zainahm3d/roadster-charger/readme.md

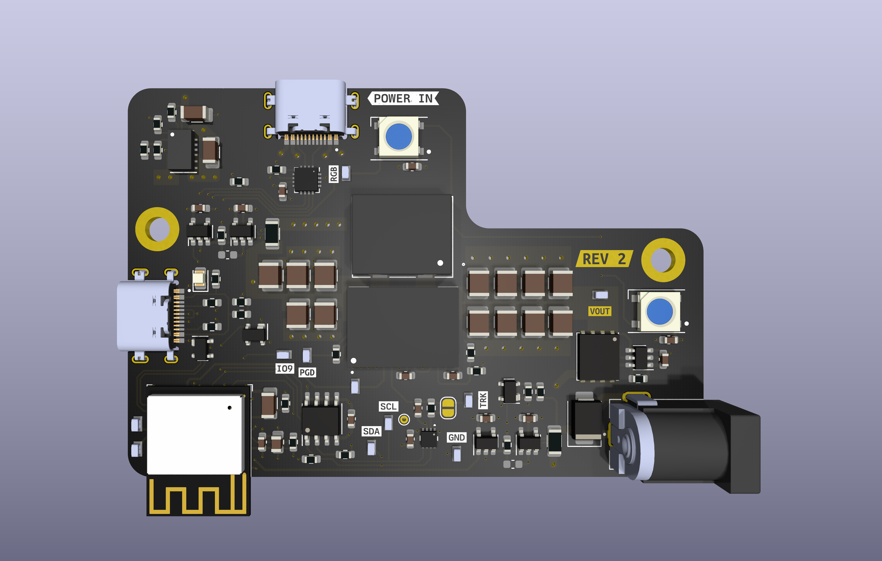
[picture p1: doc/img/pcb-front-render.png]

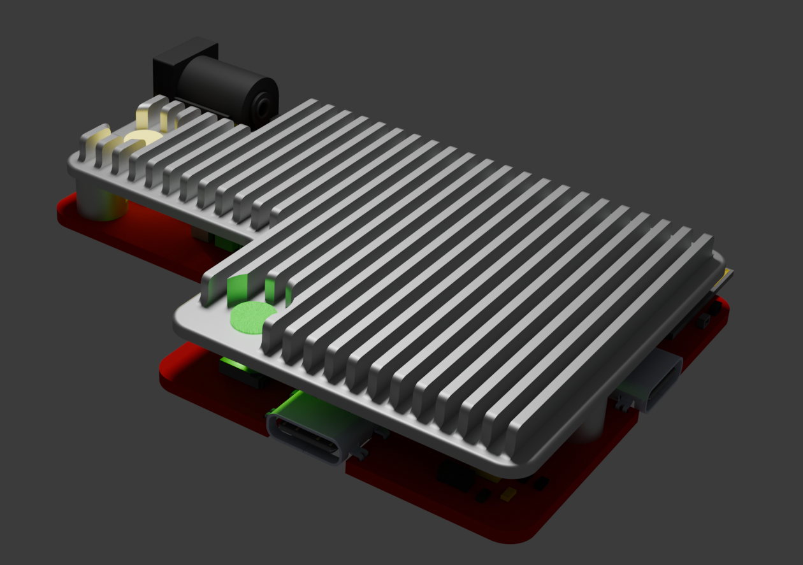
[picture p2: doc/img/heatsink-render.png]


# Roadster Charger
This project is a 100W USB-PD charger for a 36V (nominal) ebike battery. It is designed as a constant current -> constant voltage charger for the Ride1Up Roadster v2 bike.
