zainahm3d/roadster-charger/hardware/roadster-charger/components/54-00166/54-00166.step

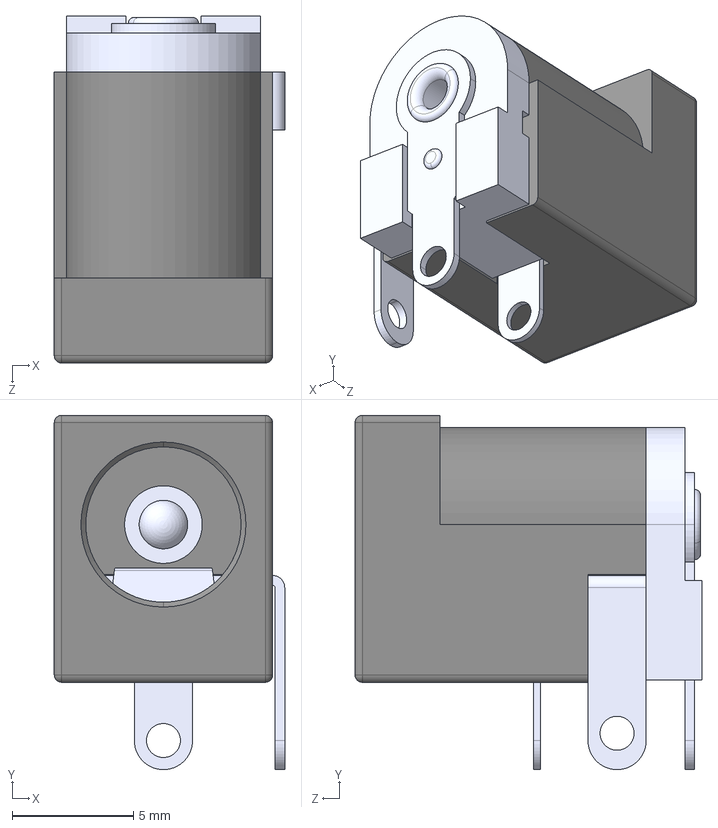
[picture p3: CAD file, 2023-12-20]
hardware/roadster-charger/components/54-00166/54-00166.step
9.50 x 14.6 x 14.3 mm
54-00166_insulator
54-00166_backplate
54-00166_center pin
54-00166_center terminal
54-00166_spring terminal
54-00166_switch terminal
