zainahm3d/roadster-charger/hardware/roadster-charger/components/LTC3786EUD_TRPBF/LTC3786EUD_TRPBF.step

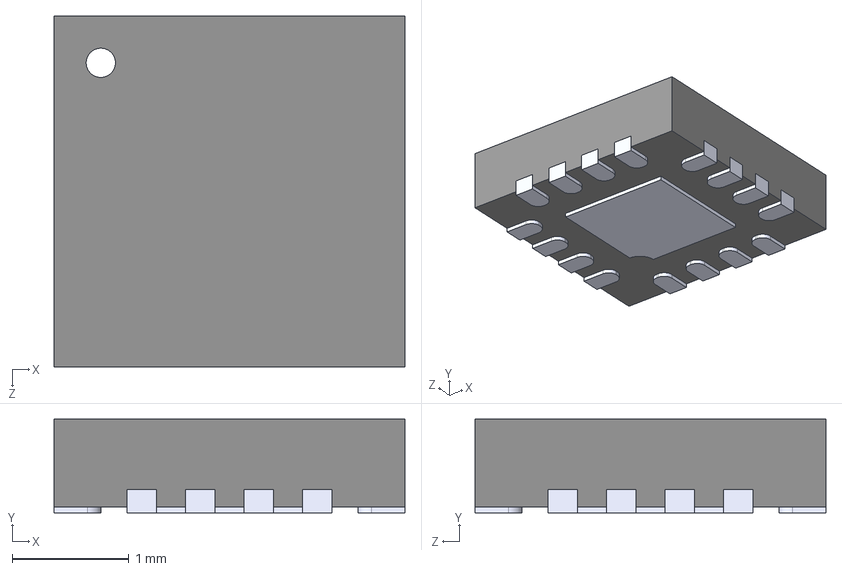
[picture p4: CAD file, 2023-12-20]
hardware/roadster-charger/components/LTC3786EUD_TRPBF/LTC3786EUD_TRPBF.step
3.00 x 0.8 x 3.00 mm
