zainahm3d/roadster-charger/hardware/roadster-charger/components/PA2050.193NL/pa2050.193nl.step

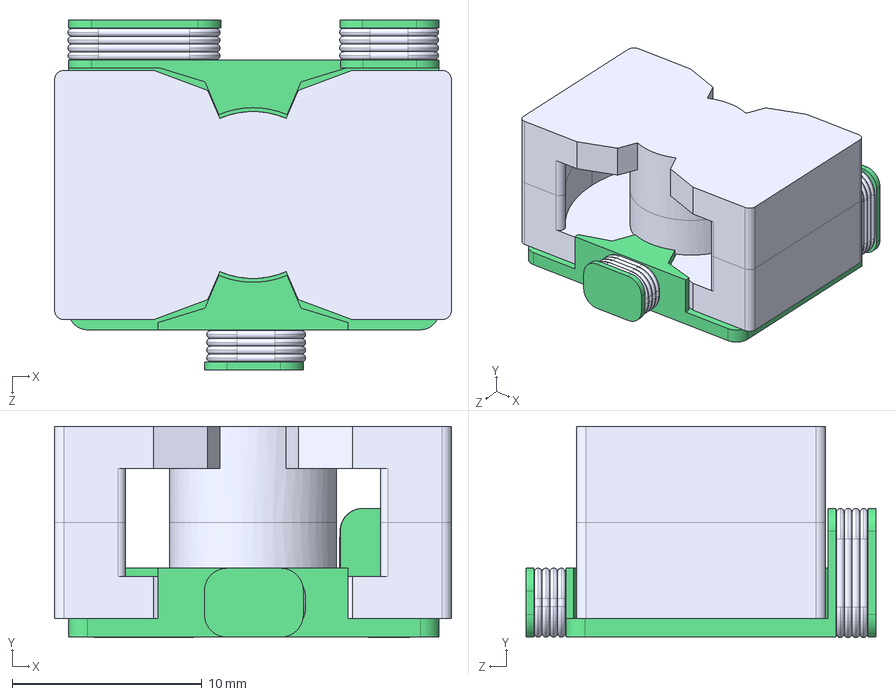
[picture p5: CAD file, 2023-12-20]
hardware/roadster-charger/components/PA2050.193NL/pa2050.193nl.step
20.9 x 11.1 x 18.4 mm
wire x 4
wire2 x 4
wire3 x 4
