zainahm3d/roadster-charger/hardware/roadster-charger/components/PA5119_421NLT/PA5119.421NLT.STEP

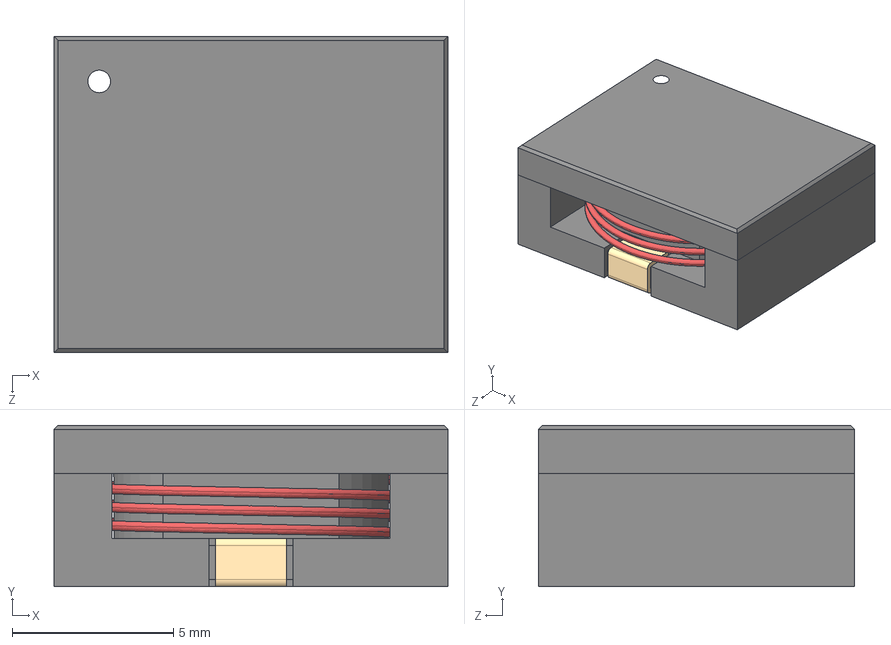
[picture p6: CAD file, 2024-10-27]
hardware/roadster-charger/components/PA5119_421NLT/PA5119.421NLT.STEP
12.2 x 5.00 x 9.80 mm
