zainahm3d/roadster-charger/hardware/roadster-charger/components/PI3740-00-LGIZ/PI3740-00-LGIZ.step

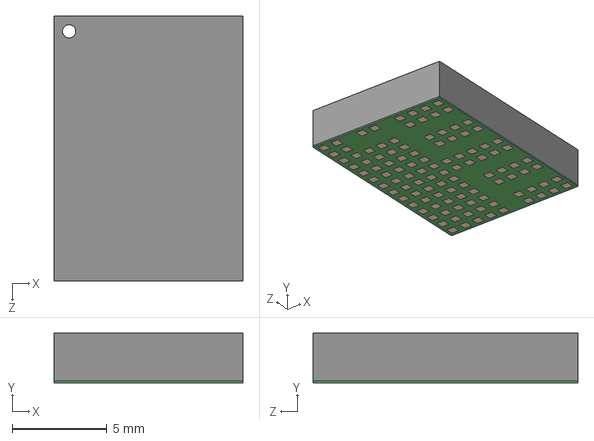
[picture p7: CAD file, 2024-10-27]
hardware/roadster-charger/components/PI3740-00-LGIZ/PI3740-00-LGIZ.step
10.0 x 2.63 x 14.0 mm
