zainahm3d/roadster-charger/hardware/roadster-charger/components/RCU-0C/RCU-0C.step

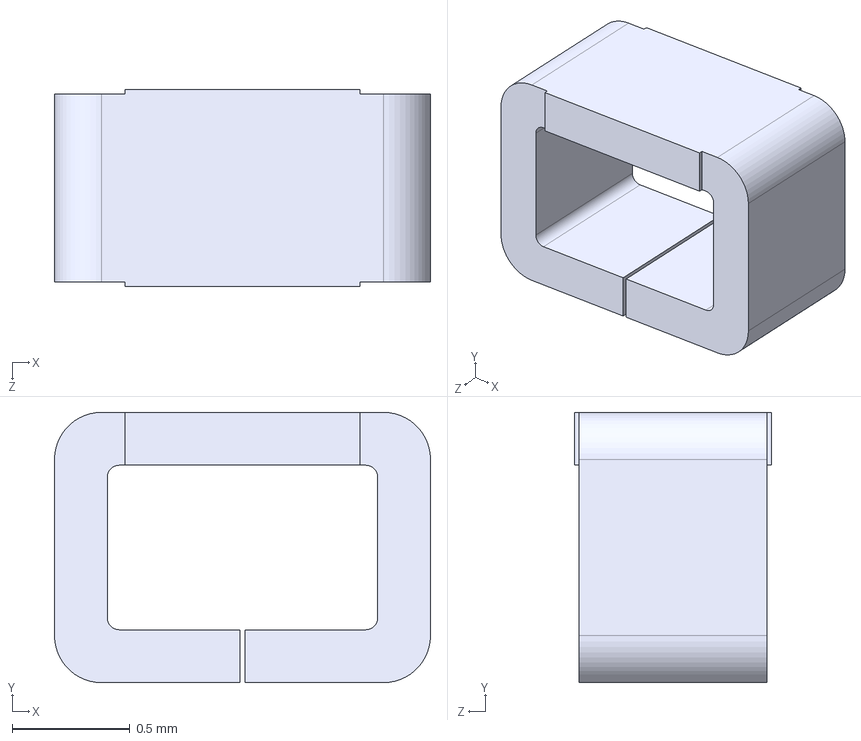
[picture p8: CAD file, 2023-12-20]
hardware/roadster-charger/components/RCU-0C/RCU-0C.step
1.60 x 1.15 x 0.84 mm
