zainahm3d/roadster-charger/hardware/roadster-charger/components/ul_MPM3606AGQV-P/MPM3606.STEP

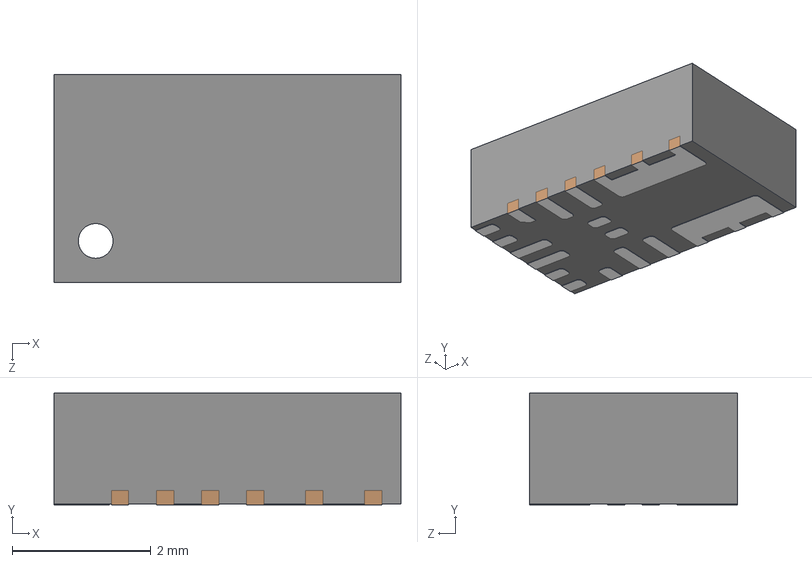
[picture p9: CAD file, 2023-12-20]
hardware/roadster-charger/components/ul_MPM3606AGQV-P/MPM3606.STEP
5.00 x 1.61 x 3.00 mm
