zainahm3d/roadster-charger/hardware/roadster-charger/components/USB4505-03-0-A_REVA/USB4505-03-0-A_REVA.step

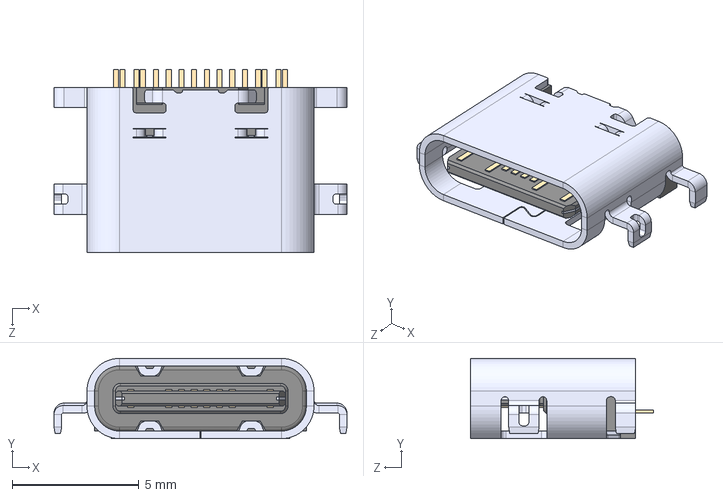
[picture p10: CAD file, 2023-08-29]
hardware/roadster-charger/components/USB4505-03-0-A_REVA/USB4505-03-0-A_REVA.step
11.5 x 3.16 x 7.20 mm
