zainahm3d/roadster-charger/hardware/roadster-charger/roadster-charger.kicad_pcb

## KiCad design hardware/roadster-charger/roadster-charger.kicad_pcb (2025-03-18)

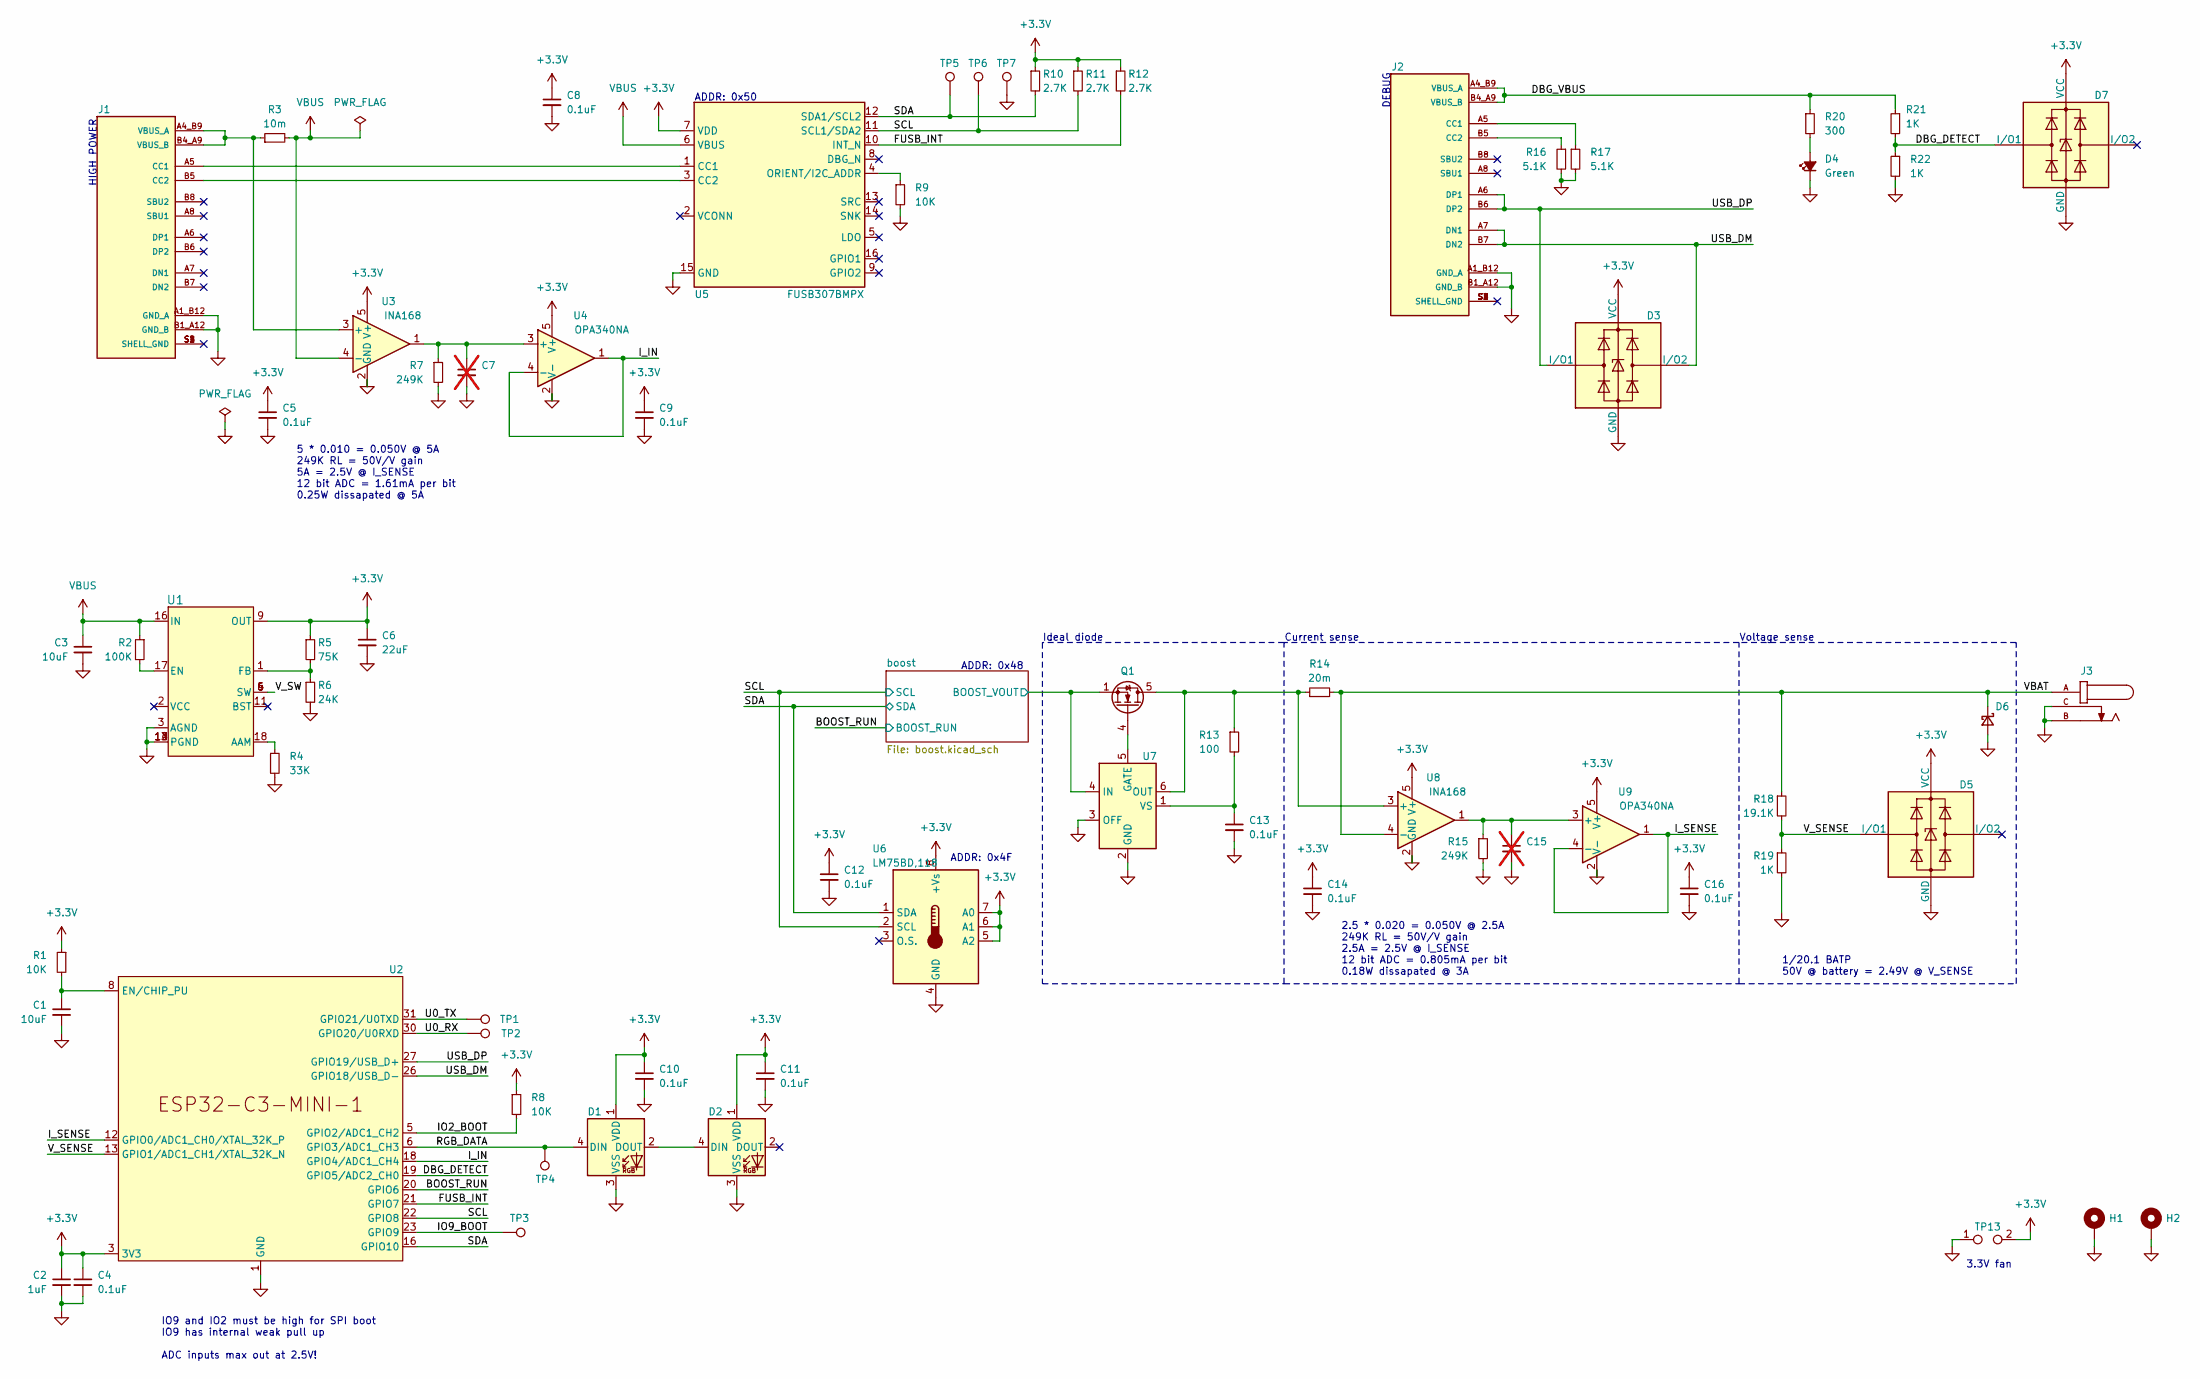
[picture p11: schematic roadster-charger.kicad_sch]

Parts:
C1, C3: 10uF; C_1206_3216Metric; MPN CL31A106MBHNNNE
C2: 1uF; C_0805_2012Metric; MPN CL21B105KAFNNNE
C4, C5, C8, C9, C10, C11, C12, C14, C16: 0.1uF; C_0603_1608Metric; MPN CL10B104KB8NNNC
C6: 22uF; C_1206_3216Metric; MPN CL31A226KAHNNNE
C7, C15: C_0603_1608Metric; MPN DNP; not fitted
C13: 0.1uF; C_0603_1608Metric; MPN CL10B104KC8NNNC
D1, D2: WS2812B; LED_WS2812B_PLCC4_5.0x5.0mm_P3.2mm; MPN COM-16347
D3, D5, D7: PRTR5V0U2X; SOT-143; MPN PRTR5V0U2X,215
D4: Green; LED_0805_2012Metric; MPN 150080VS75000
D6: D_Schottky_Small; D_SMB; MPN SMBJ60A
H1, H2: MountingHole_Pad; MountingHole_3.2mm_M3_ISO7380_Pad_TopBottom; MPN DNP
J1, J2: USB4505-03-0-A; GCT_USB4505-03-0-A_REVA; MPN USB4505-03-0-A
J3: 54-00166; TENSILITY_54-00166; MPN 54-00166
Q1: CSD19532Q5B; TDSON-8-1; MPN CSD19532Q5B
R1, R8, R9: 10K; R_0603_1608Metric; MPN RMCF0603FT10K0
R2: 100K; R_0603_1608Metric; MPN RC0603FR-07100KL
R3: 10m; R_1206_3216Metric; MPN PE1206FRF470R01L
R4: 33K; R_0603_1608Metric; MPN RMCF0603FT33K0
R5: 75K; R_0603_1608Metric; MPN RC0603FR-0775KL
R6: 24K; R_0603_1608Metric; MPN RC0603FR-1024KL
R7, R15: 249K; R_0603_1608Metric; MPN RMCF0603FT249K
R10, R11, R12: 2.7K; R_0603_1608Metric; MPN RC0603JR-072K7L
R13: 100; R_0603_1608Metric; MPN RMCF0603FT100R
R14: 20m; R_1206_3216Metric; MPN PA1206FRF470R02L
R16, R17: 5.1K; R_0603_1608Metric; MPN RC0603FR-075K1L
R18: 19.1K; R_0603_1608Metric; MPN RMCF0603FT19K1
R19, R21, R22: 1K; R_0603_1608Metric; MPN RT0603BRD071KL
R20: 300; R_0603_1608Metric; MPN RC0603JR-07330RL
TP1, TP2, TP3, TP4, TP5, TP6, TP7: RCU-0C; TP+195X110; MPN RCU-0C
TP13: TestPoint_2Pads_Pitch2.54mm_Drill0.8mm
U1: MPM3606AGQV-P; QFN3p0x5p0x1p6_MPM3606A_MNP; MPN MPM3606AGQV-P
U2: ESP32-C3-MINI-1; MPN ESP32-C3-MINI-1-N4
U3, U8: INA168; SOT-23-5; MPN INA168NA
U4, U9: OPA340NA; SOT-23-5; MPN OPA340NA
U5: FUSB307BMPX; WQFN-16-1EP_3x3mm_P0.5mm_EP1.75x1.75mm; MPN FUSB307BMPX
U6: LM75BD,118; SOIC-8_3.9x4.9mm_P1.27mm; MPN LM75BD,118
U7: LM5050-1; TSOT-23-6; MPN LM5050MKX-1/NOPB

Connections:
+3.3V: C2.1, C4.1, C5.1, C6.1, C8.1, C9.1, C10.1, C11.1, C12.1, C14.1, C16.1, D1.1 (VDD), D2.1 (VDD), D3.4 (VCC), D5.4 (VCC), D7.4 (VCC), R1.1, R5.1, R8.1, R10.1, R11.1, R12.1, TP13.2, U1.7 (OUT), U1.8 (OUT), U1.9 (OUT), U2.3 (3V3), U3.5 (V+), U4.5 (V+), U5.7 (VDD), U6.5 (A2), U6.6 (A1), U6.7 (A0), U6.8 (+Vs), U8.5 (V+), U9.5 (V+); also elsewhere on the board
/BOOST_RUN: U2.20 (GPIO6); also elsewhere on the board
/DBG_DETECT: D7.2 (I/O1), R21.2, R22.1, U2.19 (GPIO5/ADC2_CH0)
/DBG_VBUS: J2.A4_B9 (VBUS_A), J2.B4_A9 (VBUS_B), R20.1, R21.1
/FUSB_INT: R12.2, U2.21 (GPIO7), U5.10 (INT_N)
/IO2_BOOT: R8.2, U2.5 (GPIO2/ADC1_CH2)
/IO9_BOOT: TP3.1, U2.23 (GPIO9)
/I_IN: U2.18 (GPIO4/ADC1_CH4), U4.1, U4.4 (-)
/I_SENSE: U2.12 (GPIO0/ADC1_CH0/XTAL_32K_P), U9.1, U9.4 (-)
/RGB_DATA: D1.4 (DIN), TP4.1, U2.6 (GPIO3/ADC1_CH3)
/SCL: R11.2, TP6.1, U2.22 (GPIO8), U5.11 (SCL1/SDA2), U6.2 (SCL); also elsewhere on the board
/SDA: R10.2, TP5.1, U2.16 (GPIO10), U5.12 (SDA1/SCL2), U6.1 (SDA); also elsewhere on the board
/U0_RX: TP2.1, U2.30 (GPIO20/U0RXD)
/U0_TX: TP1.1, U2.31 (GPIO21/U0TXD)
/USB_DM: D3.3 (I/O2), J2.A7 (DN1), J2.B7 (DN2), U2.26 (GPIO18/USB_D-)
/USB_DP: D3.2 (I/O1), J2.A6 (DP1), J2.B6 (DP2), U2.27 (GPIO19/USB_D+)
/VBAT: D6.1 (K), J3.A, R14.2, R18.1, U8.4 (-)
/V_SENSE: D5.2 (I/O1), R18.2, R19.1, U2.13 (GPIO1/ADC1_CH1/XTAL_32K_N)
/V_SW: U1.4 (SW), U1.5 (SW), U1.6 (SW)
/boost/BOOST_VOUT: Q1.1 (S), Q1.2 (S), Q1.3 (S), U7.4 (IN); also elsewhere on the board
GND: C1.2, C2.2, C3.2, C4.2, C5.2, C6.2, C7.2, C8.2, C9.2, C10.2, C11.2, C12.2, C13.2, C14.2, C15.2, C16.2, D1.3 (VSS), D2.3 (VSS), D3.1 (GND), D4.1 (K), D5.1 (GND), D6.2 (A), D7.1 (GND), H1.1, H2.1, J1.A1_B12 (GND_A), J1.B1_A12 (GND_B), J2.A1_B12 (GND_A), J2.B1_A12 (GND_B), J3.B, J3.C, R4.2, R6.2, R7.2, R9.2, R15.2, R16.2, R17.2, R19.2, R22.2, TP7.1, TP13.1, U1.3 (AGND), U1.12 (PGND), U1.13 (PGND), U1.14 (PGND), U2.1 (GND), U2.2 (GND), U2.11 (GND), U2.14 (GND), U2.36 (GND), U2.37 (GND), U2.38 (GND), U2.39 (GND), U2.40 (GND), U2.41 (GND), U2.42 (GND), U2.43 (GND), U2.44 (GND), U2.45 (GND), U2.46 (GND), U2.47 (GND), U2.48 (GND), U2.49 (GND), U2.50 (GND), U2.51 (GND), U2.52 (GND), U2.53 (GND), U3.2 (GND), U4.2 (V-), U5.15 (GND), U5.17 (GND), U6.4 (GND), U7.2 (GND), U7.3 (OFF), U8.2 (GND), U9.2 (V-); also elsewhere on the board
unnamed: D1.2 (DOUT), D2.4 (DIN)
unnamed: D4.2 (A), R20.2
unnamed: J1.A5 (CC1), U5.1 (CC1)
unnamed: J1.B5 (CC2), U5.3 (CC2)
unnamed: J1.A4_B9 (VBUS_A), J1.B4_A9 (VBUS_B), R3.1, U3.3 (+)
unnamed: J2.A5 (CC1), R17.1
unnamed: J2.B5 (CC2), R16.1
unnamed: Q1.5 (D), R13.1, R14.1, U7.6 (OUT), U8.3 (+)
unnamed: Q1.4 (G), U7.5 (GATE)
unnamed: R4.1, U1.18 (AAM)
unnamed: R2.2, U1.17 (EN)
unnamed: R5.2, R6.1, U1.1 (FB)
unnamed: C1.1, R1.2, U2.8 (EN/CHIP_PU)
unnamed: C7.1, R7.1, U3.1, U4.3 (+)
unnamed: R9.1, U5.4 (ORIENT/I2C_ADDR)
unnamed: C13.1, R13.2, U7.1 (VS)
unnamed: C15.1, R15.1, U8.1, U9.3 (+)
VBUS: C3.1, R2.1, R3.2, U1.16 (IN), U3.4 (-), U5.6 (VBUS); also elsewhere on the board

Notes on the sheet:
ADDR: 0x50
5 * 0.010 = 0.050V @ 5A 249K RL = 50V/V gain 5A = 2.5V @ I_SENSE 12 bit ADC = 1.61mA per bit 0.25W dissapated @ 5A
3.3V fan
Ideal diode
1/20.1 BATP 50V @ battery = 2.49V @ V_SENSE
DEBUG
HIGH POWER
Current sense
IO9 and IO2 must be high for SPI boot IO9 has internal weak pull up ADC inputs max out at 2.5V!
ADDR: 0x48
ADDR: 0x4F
Voltage sense
2.5 * 0.020 = 0.050V @ 2.5A 249K RL = 50V/V gain 2.5A = 2.5V @ I_SENSE 12 bit ADC = 0.805mA per bit 0.18W dissapated @ 3A

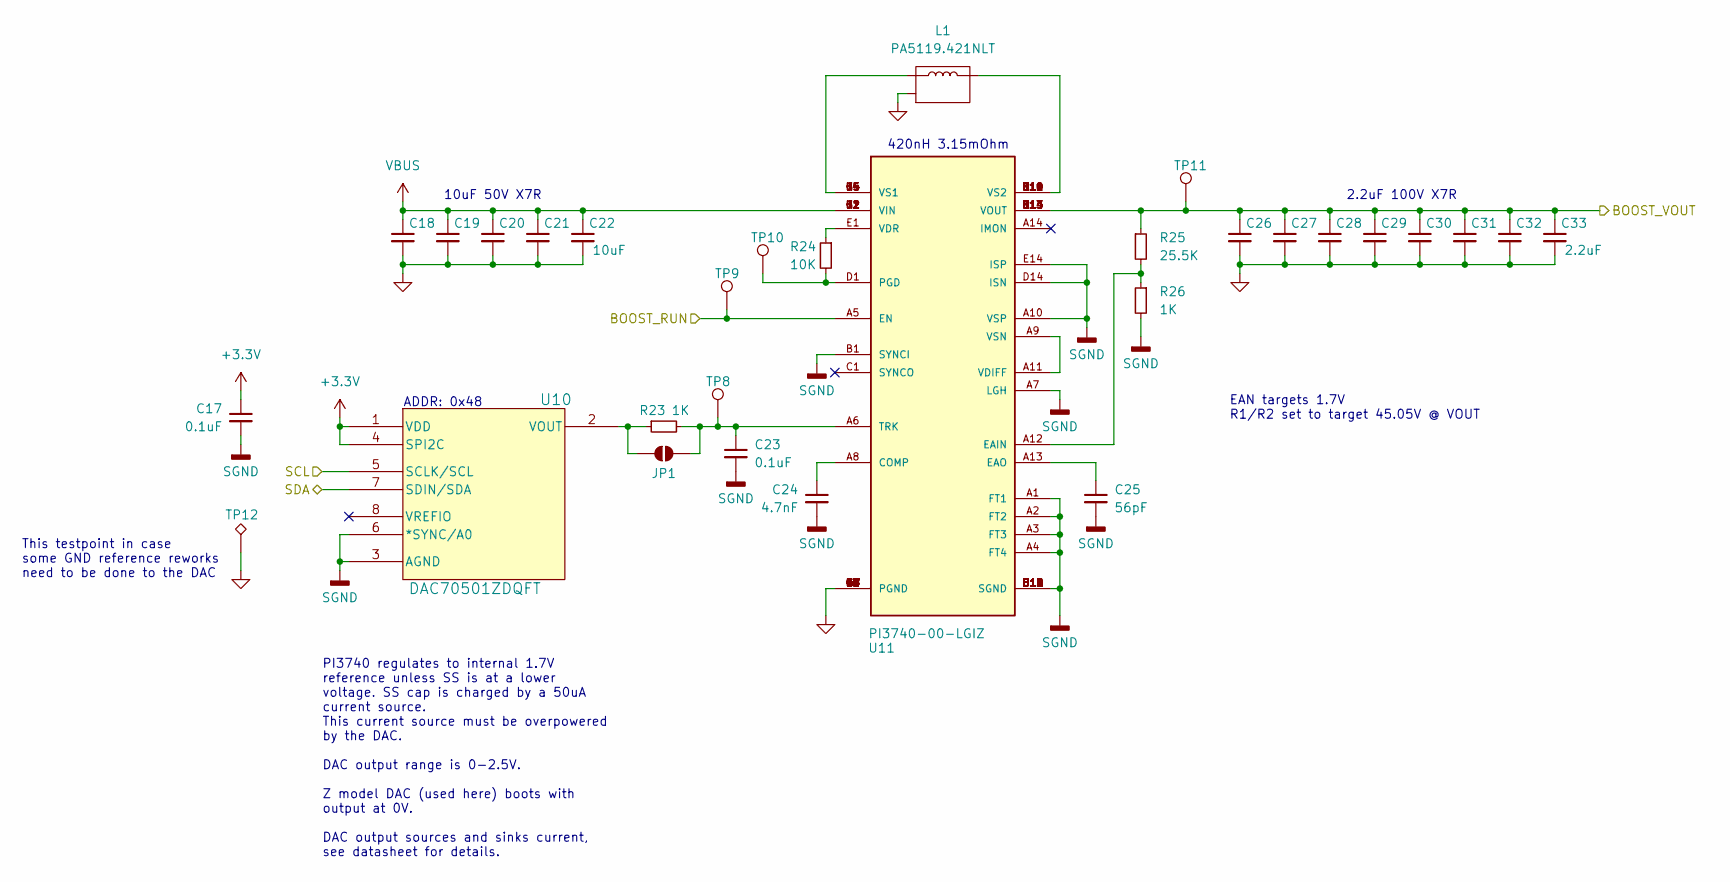
[picture p12: schematic boost.kicad_sch]

Parts:
C17, C23: 0.1uF; C_0603_1608Metric; MPN CL10B104KB8NNNC
C18, C19, C20, C21, C22: 10uF; C_1210_3225Metric; MPN CL32B106KBVVPLE
C24: 4.7nF; C_0603_1608Metric; MPN C0603C472K4RECAUTO7411
C25: 56pF; C_0603_1608Metric; MPN C0603C560G5GAC7867
C26, C27, C28, C29, C30, C31, C32, C33: 2.2uF; C_1210_3225Metric; MPN GRM32ER72A225KA35L
JP1: SolderJumper_2_Open; SolderJumper-2_P1.3mm_Open_RoundedPad1.0x1.5mm; MPN DNP
L1: PA5119.421NLT; SMT_119.421NLT_PUL; MPN PA5119.421NLT
R23, R26: 1K; R_0603_1608Metric; MPN RT0603BRD071KL
R24: 10K; R_0603_1608Metric; MPN RMCF0603FT10K0
R25: 25.5K; R_0603_1608Metric; MPN RT0603BRD0725K5L
TP8, TP9, TP10, TP11: RCU-0C; TP+195X110; MPN RCU-0C
TP12: TestPoint_Alt; TestPoint_THTPad_D1.0mm_Drill0.5mm; MPN DNP
U10: DAC70501ZDQFT; WSON8_2P1X2P1_TEX; MPN DAC70501ZDQFT
U11: PI3740-00-LGIZ; LGA108S100P10X14_1000X1400X263N; MPN PI3740-00-LGIZ

Connections:
+3.3V: C17.1, U10.1 (VDD), U10.4 (SPI2C); also elsewhere on the board
/BOOST_RUN: TP9.1, U11.A5 (EN); also elsewhere on the board
/SCL: U10.5 (SCLK/SCL); also elsewhere on the board
/SDA: U10.7 (SDIN/SDA); also elsewhere on the board
/boost/BOOST_VOUT: C26.1, C27.1, C28.1, C29.1, C30.1, C31.1, C32.1, C33.1, R25.1, TP11.1, U11.G13 (VOUT), U11.G14 (VOUT), U11.H13 (VOUT), U11.H14 (VOUT), U11.J13 (VOUT), U11.J14 (VOUT), U11.K13 (VOUT), U11.K14 (VOUT); also elsewhere on the board
GND: C18.2, C19.2, C20.2, C21.2, C22.2, C26.2, C27.2, C28.2, C29.2, C30.2, C31.2, C32.2, C33.2, L1.3 (MNT), TP12.1, U11.B2 (PGND), U11.B3 (PGND), U11.B4 (PGND), U11.B5 (PGND), U11.B6 (PGND), U11.B7 (PGND), U11.B8 (PGND), U11.B9 (PGND), U11.C2 (PGND), U11.C3 (PGND), U11.C4 (PGND), U11.C5 (PGND), U11.C6 (PGND), U11.C7 (PGND), U11.C8 (PGND), U11.C9 (PGND), U11.D2 (PGND), U11.D3 (PGND), U11.D4 (PGND), U11.D5 (PGND), U11.D6 (PGND), U11.D7 (PGND), U11.D8 (PGND), U11.D9 (PGND), U11.E2 (PGND), U11.E3 (PGND), U11.E4 (PGND), U11.E5 (PGND), U11.E6 (PGND), U11.E7 (PGND), U11.E8 (PGND), U11.E9 (PGND), U11.F7 (PGND), U11.F8 (PGND), U11.G7 (PGND), U11.G8 (PGND), U11.H7 (PGND), U11.H8 (PGND), U11.J7 (PGND), U11.J8 (PGND), U11.K7 (PGND), U11.K8 (PGND); also elsewhere on the board
unnamed: C23.1, JP1.1 (A), R23.2, TP8.1, U11.A6 (TRK)
unnamed: JP1.2 (B), R23.1, U10.2 (VOUT)
unnamed: L1.1, U11.G10 (VS2), U11.G11 (VS2), U11.H10 (VS2), U11.H11 (VS2), U11.J10 (VS2), U11.J11 (VS2), U11.K10 (VS2), U11.K11 (VS2)
unnamed: L1.2, U11.G4 (VS1), U11.G5 (VS1), U11.H4 (VS1), U11.H5 (VS1), U11.J4 (VS1), U11.J5 (VS1), U11.K4 (VS1), U11.K5 (VS1)
unnamed: C24.1, U11.A8 (COMP)
unnamed: R25.2, R26.1, U11.A12 (EAIN)
unnamed: C25.1, U11.A13 (EAO)
unnamed: R24.2, TP10.1, U11.D1 (PGD)
unnamed: U11.A9 (VSN), U11.A11 (VDIFF)
unnamed: R24.1, U11.E1 (VDR)
SGND: C17.2, C23.2, C24.2, C25.2, R26.2, U10.3 (AGND), U10.6 (*SYNC/A0), U11.A1 (FT1), U11.A2 (FT2), U11.A3 (FT3), U11.A4 (FT4), U11.A7 (LGH), U11.A10 (VSP), U11.B1 (SYNCI), U11.B10 (SGND), U11.B11 (SGND), U11.B12 (SGND), U11.B13 (SGND), U11.B14 (SGND), U11.C10 (SGND), U11.C11 (SGND), U11.C12 (SGND), U11.D10 (SGND), U11.D11 (SGND), U11.D12 (SGND), U11.D14 (ISN), U11.E10 (SGND), U11.E11 (SGND), U11.E12 (SGND), U11.E14 (ISP)
VBUS: C18.1, C19.1, C20.1, C21.1, C22.1, U11.G1 (VIN), U11.G2 (VIN), U11.H1 (VIN), U11.H2 (VIN), U11.J1 (VIN), U11.J2 (VIN), U11.K1 (VIN), U11.K2 (VIN); also elsewhere on the board

Notes on the sheet:
EAN targets 1.7V R1/R2 set to target 45.05V @ VOUT
ADDR: 0x48
This testpoint in case some GND reference reworks need to be done to the DAC
2.2uF 100V X7R
10uF 50V X7R
420nH 3.15mOhm
PI3740 regulates to internal 1.7V reference unless SS is at a lower voltage. SS cap is charged by a 50uA current source. This current source must be overpowered by the DAC. DAC output range is 0-2.5V. Z model DAC (used here) boots with output at 0V. DAC output sources and sinks current, see datashe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

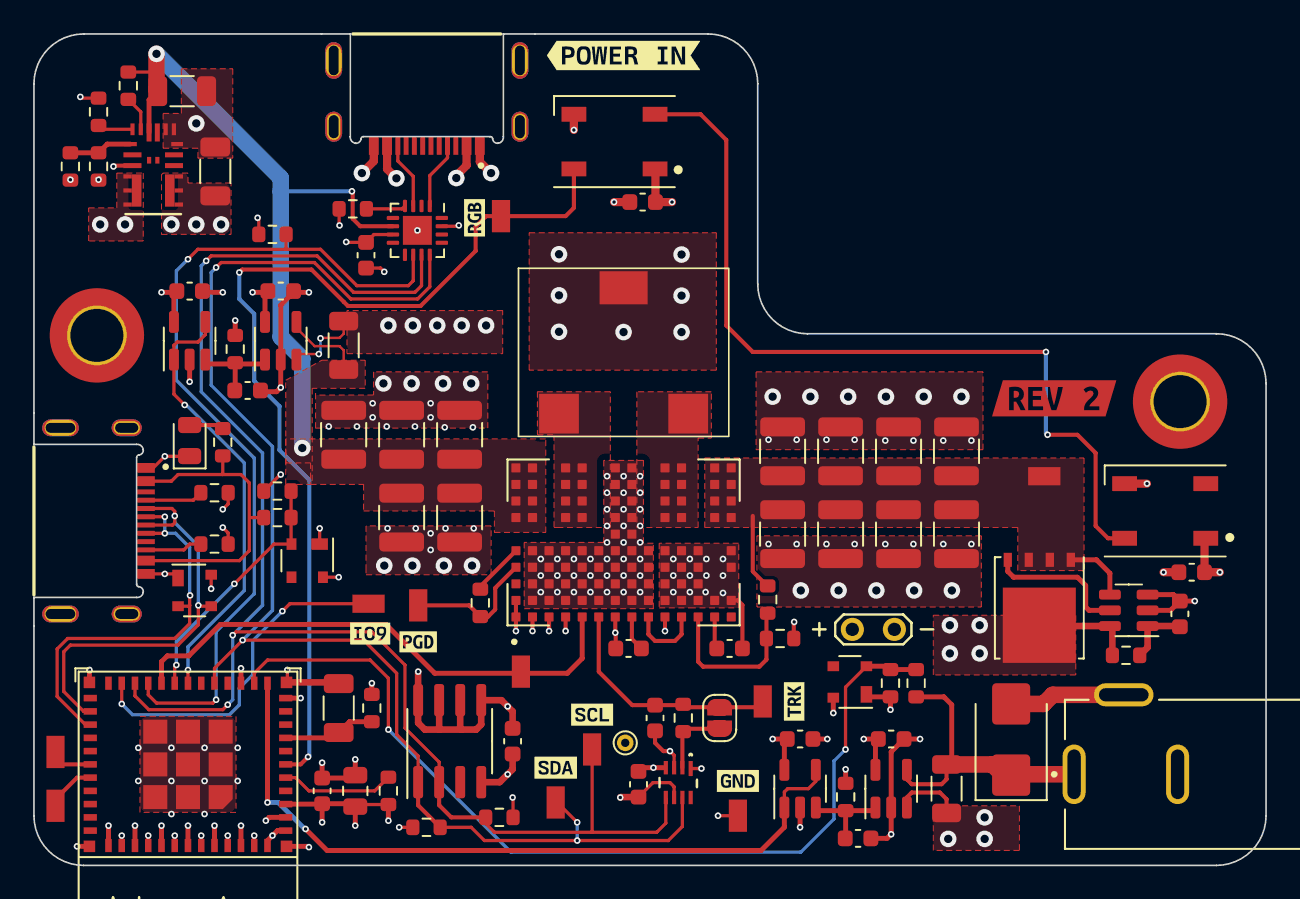
[picture p13: board roadster-charger.kicad_pcb from above]

Board: 4 copper layers, 74.4 x 50.2 mm, 108 parts (0 on the bottom side), 50 nets.

Other parts of the board:
kibuzzard-657BAFF1: G***; kibuzzard-657BAFF1
kibuzzard-657BAFFB: G***; kibuzzard-657BAFFB
kibuzzard-657BB0E9: G***; kibuzzard-657BB0E9
kibuzzard-657BB005: G***; kibuzzard-657BB005
kibuzzard-657FB5DD: G***; kibuzzard-657FB5DD
kibuzzard-671EA982: G***; kibuzzard-671EA982
kibuzzard-671EA992: G***; kibuzzard-671EA992
kibuzzard-671EAE84: G***; kibuzzard-671EAE84
kibuzzard-671EB1B0: G***; kibuzzard-671EB1B0
kibuzzard-67218F63: G***; kibuzzard-67218F63
