zainahm3d/roadster-charger/(commit log)

2023-12-20 Rev 1 PCB (#1)
    * rough out boost converter
    * add v/i sense, ideal diode, cleanup
    * add buffer to I_SENSE
    * add readme, swap out lv buck, swap n fets
    * schematic cleanup and labeling
    * add current sense to VBUS
    * cleanup input current sense, assign some footprints
    * swapped LTM8074 with cheaper MPM3606A
    * fix accidental schem. grid change, add footprints and MPNs
    * edit ERC rules, clean up ERC errors, cleanup more off grid parts
    * import to PCB, build layout packs
    * wip routing
    * add LM75 i2c current sensor
    * add AAM resistor to 3V3 regulator, validate feedback resistors
    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
    [54-00166.step, LTC3786EUD_TRPBF.step, MPM3606.STEP, RCU-0C.step, TES_1-0523.step, USB4505-03-0-A_REVA.step, boost.kicad_sch, pa2050.193nl.step]
2023-12-20 change vout voltage divider to target max 2.5V @ 50V at battery
    [roadster-charger.kicad_pcb, roadster-charger.kicad_sch]
2024-01-21 Firmware Bringup + test implementation of PD (#2)
    * woo all i2c devices work
    * confirm comms with LM75
    * confirm comms with fusb307
    * test cc line orientation detection
    * gross wip test code, goodCRC works!
    * disconnect unused CC line rd to allow transmission on CC1 and CC2
    * remove look4connection, bump i2c speed to 400k, disable boost now that the hw is good
    * cleanup
    * start filling in FUSB307 bitfields
    * bitfields are sick
    * create read_reg and write_reg functions
    * scaffold out more bitfields
    * add header definition
    * rename fusb307 to tcpc
    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
2024-01-26 connect FUSB307 vbus pin
    [boost.kicad_sch, roadster-charger.kicad_pcb, roadster-charger.kicad_sch]
2024-02-24 update dependencies, todo: update esp32c3 hal
2024-02-24 service post-negotiation PD messages in an interrupt
2024-02-24 remove boot print
2024-02-26 write ws28128b driver, turn on LEDs for PD status
2024-03-02 allow back to back led updates
2024-03-02 tcpc exposes pdo current and voltage
2024-03-02 increase led inter frame time
2024-05-13 bring up ADC
2024-06-01 print status lines while script is running
2024-06-01 [Very WIP] start building out state machine for charger logic
2024-09-08 Update to KiCad 8 + sneaky resistor PN correction
    Update checkout and artifact actions
    Remove specific board outputs from actions file (kicad bug fixed now)
    [boost.kicad_sch, roadster-charger.kicad_pcb, roadster-charger.kicad_sch]
2024-09-10 CV charging based on battery voltage
2024-09-11 clippy+rustfmt in CI, correct boost error logic
    [boost.rs]
2024-10-27 Rough rev 2 layout
    Move boost run pin to GPIO6 to avoid hard coded UART output
    [PA5119.421NLT.STEP, PI3740-00-LGIZ.step, boost.kicad_sch, roadster-charger.kicad_pcb, roadster-charger.kicad_sch]
2024-10-28 add debug connected LED
    [boost.kicad_sch, roadster-charger.kicad_pcb, roadster-charger.kicad_sch]
2024-10-28 change all 1K Rs to 0.1%, invert DAC jumpers
    [boost.kicad_sch, roadster-charger.kicad_pcb, roadster-charger.kicad_sch]
2024-10-30 reannotate, add uart test points
    [boost.kicad_sch, roadster-charger.kicad_pcb, roadster-charger.kicad_sch]
2024-10-30 use track cleanup tool
    [roadster-charger.kicad_pcb, roadster-charger.kicad_sch]
2024-11-01 Correct Vicor grounding and redo boost layout
    [boost.kicad_sch, roadster-charger.kicad_pcb]
2024-11-01 unify zone clearance and width settings
    [roadster-charger.kicad_pcb]
2024-11-02 one more big grounding change
    [boost.kicad_sch, roadster-charger.kicad_pcb]
2024-11-03 ERC / DRC cleanup
    [boost.kicad_sch, roadster-charger.kicad_pcb, roadster-charger.kicad_sch]
2024-11-03 Fix res PN, remove TPs from BOM, add DNPs to BOM
    [boost.kicad_sch, roadster-charger.kicad_sch]
2024-11-03 Change bom output to CSV
    [roadster-charger.kicad_pcb, roadster-charger.kicad_sch]
2024-11-03 Undo DNPs in BOM, update cap PN
    [boost.kicad_sch, roadster-charger.kicad_sch]
2024-11-28 Add capacitor labels
    [boost.kicad_sch]
2024-11-28 Bump shunts to 1W 1206 parts
    [roadster-charger.kicad_pcb, roadster-charger.kicad_sch]
2024-11-28 Move LEDs near input and output ports
    [roadster-charger.kicad_pcb]
2024-12-01 prune bogus symbol fields
    [boost.kicad_sch, roadster-charger.kicad_sch]
2024-12-01 re-add all TPs but TP12 to BOM
    [boost.kicad_sch, roadster-charger.kicad_pcb, roadster-charger.kicad_sch]
2024-12-01 cleanup 3.3V buck pour
    [roadster-charger.kicad_pcb]
2024-12-09 thicken up some power tracks
    [roadster-charger.kicad_pcb]
2024-12-15 connect inductor mounting pin to large ground area
    [boost.kicad_sch, roadster-charger.kicad_pcb]
2024-12-21 increase input capacitance for buck / boost
    [boost.kicad_sch, roadster-charger.kicad_pcb]
2024-12-24 add periodic timer and soft reset if we are already connected to a PD source
    [main.rs, tcpc.rs, usb_pd.rs]
2024-12-27 clean up USB
    [roadster-charger.kicad_pcb]
2024-12-29 move update logic into timer handler
2024-12-29 Change DAC to output 0-2.5V for new HW
2025-01-13 Correct resistor from 1206 to 0603
    [boost.kicad_sch, roadster-charger.kicad_pcb]
2025-01-25 Use generic i2c and digital pins
2025-02-25 bump to kicad 9
    [boost.kicad_sch, roadster-charger.kicad_pcb, roadster-charger.kicad_sch]
2025-03-09 redo charger logic
2025-03-09 add a cap discharge period before reenabling disabled charger
2025-03-09 calculate charge current based on connect supply
2025-03-11 strucify VI_SENSE and LED drivers
2025-03-15 Small updates from Rev 2 production run
    [roadster-charger.kicad_pcb, roadster-charger.kicad_sch]
2025-03-15 limit CV voltage slew rate within 100mV of target
2025-03-18 add fan connection points
    [roadster-charger.kicad_pcb, roadster-charger.kicad_sch]
2025-04-18 add heatsink render
